TechxArtisan/Openterface_KeyMod_Hardware/hardware/v1_29(keymode plus)/BOM_29keymod plus_PCB24_30_2026-08-19.xlsx

No. | Quantity | Comment | Designator | Footprint | Value | Manufacturer Part | Manufacturer | Supplier Part | Supplier
1 | 2 | 12pF | C1,C2 | C0402 | 12pF
2 | 1 | 10uF | C11 | C0402 | 10uF | HGC0402R5106M100NTEJ | Chinocera(华瓷) | C7472949 | LCSC
3 | 1 | 100nF | C12 | C0402 | 100nF | CL05B104KO5NNNC | SAMSUNG(三星) | C1525 | LCSC
4 | 3 | 1uF | C13,C26,C27 | C0402 | 1uF
5 | 3 | 100nF | C15,C17,C20 | C0402 | 100nF
6 | 1 | 22nF | C25 | C0402 | 22nF
7 | 2 | B5819WS | D1,D3 | SOD-323_L1.8-W1.3-LS2.5-RD |  | B5819WS |  | C499641 | LCSC
8 | 1 | ANT-F-2-2.4G-0.8mmFR4_1 | E2 | ANT-F-2-2.4G-0.8mmFR4_1
9 | 1 | LED_0402-G | LED1 | LED_0402
10 | 2 | 10kΩ | R3,R4 | R0402 | 10kΩ | 0402WGF1002TCE | UNI-ROYAL(厚声) | C25744 | LCSC
11 | 2 | 5.1K | R9,R22 | R0402 | 5.1K
12 | 1 | 10K | R20 | R0402 | 10K
13 | 1 | 10k | R21 | R0402 | 10k
14 | 1 | B3U-1000P | SW1 | KEY-SMD_B3U-1000PM |  | B3U-1000P | OMRON(欧姆龙) | C231329 | LCSC
15 | 1 | CH32V208GBU6 | U2 | QFN-28_L4.0-W4.0-P0.40-BL-EP2.8 |  | CH32V208GBU6 | WCH(南京沁恒) | C7434833 | LCSC
16 | 1 | SY6280AAC | U6 | SOT-23-5_L3.0-W1.7-P0.95-LS2.8-BL |  | SY6280AAC | silergy(矽力杰) | C55136 | LCSC
17 | 1 | RT9193-33GB | U25 | SOT-23-5_L3.0-W1.7-P0.95-LS2.8-BL |  | RT9193-33GB | RICHTEK(立锜) | C15651 | LCSC
18 | 1 | USB-212-BCW | USB1 | USB-A-SMD_USB-212-BCW |  | USB-212-BCW | XUNPU(讯普) | C720521 | LCSC
19 | 1 | TYPE-C 16PIN 2MD(073) | USB2 | USB-C-SMD_TYPE-C-16PIN-2MD-073 |  | TYPE-C 16PIN 2MD(073) | SHOU HAN(首韩) | C2765186 | LCSC
20 | 1 | 32.768kHz | X1 | CRYSTAL-SMD_2P-L2.0-W1.2 | 32.768kHz | XKHEL89CGI-112YLC-32.768K | YXC(扬兴晶振) | C7500573 | LCSC
21 | 1 | 32MHz | X3 | CRYSTAL-SMD_4P-L3.2-W2.5-BL | 32MHz | X322532MOB4SI | YXC(扬兴晶振) | C9009 | LCSC
