TechxArtisan/Openterface_KeyMod_Hardware/hardware/v1_29(keymode plus)/3D_PCB24_30_2026-08-19.step

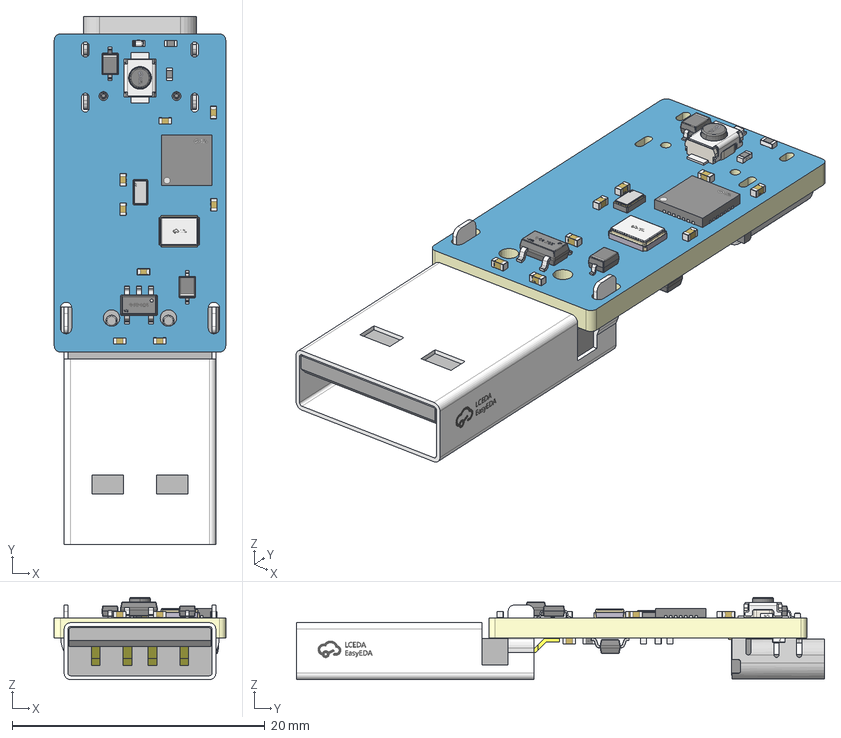
[picture p1: CAD file, 2026-08-19]
hardware/v1_29(keymode plus)/3D_PCB24_30_2026-08-19.step
13.6 x 41.8 x 6.50 mm
Board~2uqJ
TopCopper~2uqJ
BottomCopper~2uqJ
TopSilkscreen~2uqJ
BottomSilkscreen~2uqJ
TopFpcStiffener~2uqJ
BottomFpcStiffener~2uqJ
LED_0402~LED0402-RD_ORANGE~plJm
ANT-F-2-2.4G-0.8mmFR4_1~RES-SMD_L2.0-W1.2-R1-10K-R2-20K~k0gQ
R0402~R0402_L1.0-W0.5-H0.5~JtEf x 2
CRYSTAL-SMD_2P-L2.0-W1.2~CRYSTAL-SMD_2P-L2.0-W1.2~otiJ
R0402~R0402_L1.0-W0.5-H0.4~VwKX x 4
KEY-SMD_B3U-1000PM~KEY-SMD_2P-L3.0-W2.5-H1.6-LS4.0~yrwB
C0402~C0402_L1.0-W0.5-H0.5~60uz x 11
SOD-323_L1.8-W1.3-LS2.5-RD~SOD-323_L1.8-W1.3-LS2.5-RD~587r x 2
CRYSTAL-SMD_4P-L3.2-W2.5-BL~CRYSTAL-SMD_4P-L3.2-W2.5-BL~9JKJ
SOT-23-5_L3.0-W1.7-P0.95-LS2.8-BL~SOT-23-5_L2.9-W1.6-H1.1-LS2.8-P0.95~0K0i x 2
USB-C-SMD_TYPE-C-16PIN-2MD-073~USB-C-SMD_TYPE-C-6PIN-2MD-073~PgNu
USB-A-SMD_USB-212-BCW~USB-A-SMD_USB-212-BCW~Nbmz
QFN-28_L4.0-W4.0-P0.40-BL-EP2.8~QFN-28_L4.0-W4.0-P0.40-BL-EP2.8~fo4n
