TechxArtisan/Openterface_KeyMod_Hardware/hardware/v1_30(keymode)/3D_PCB24_23_2026-08-19.step

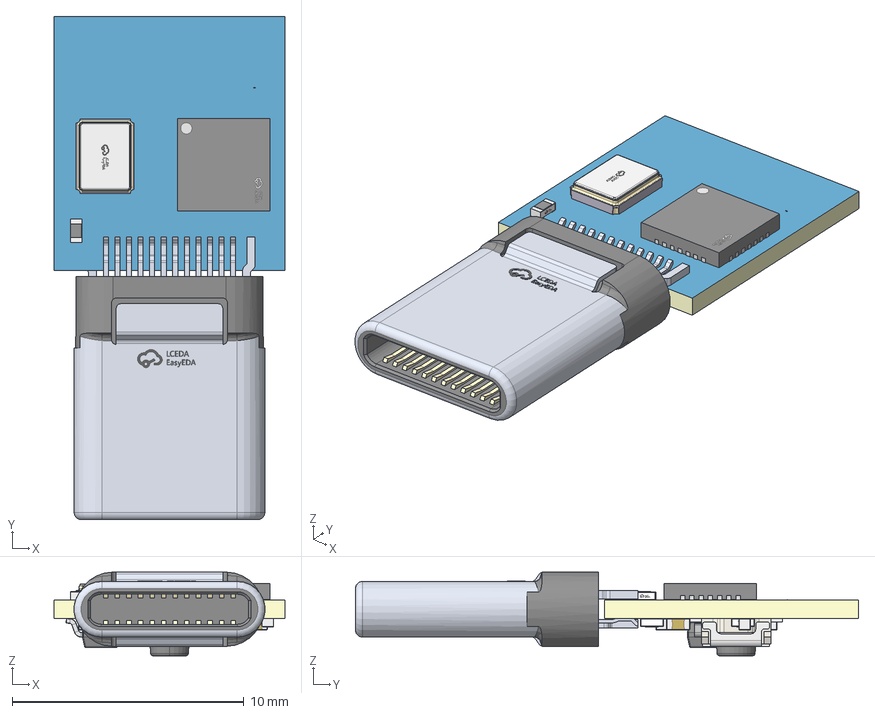
[picture p2: CAD file, 2026-08-19]
hardware/v1_30(keymode)/3D_PCB24_23_2026-08-19.step
9.97 x 21.7 x 3.61 mm
Board~ZbYg
TopCopper~ZbYg
BottomCopper~ZbYg
TopSilkscreen~ZbYg
BottomSilkscreen~ZbYg
TopFpcStiffener~ZbYg
BottomFpcStiffener~ZbYg
CRYSTAL-SMD_4P-L3.2-W2.5-BL~CRYSTAL-SMD_4P-L3.2-W2.5-BL~TsUA
C0402~C0402_L1.0-W0.5-H0.5~thjE x 4
R0402~R0402_L1.0-W0.5-H0.4~OVhD x 3
SOT-23-5_L3.0-W1.7-P0.95-LS2.8-BL~SOT-23-5_L2.9-W1.6-H1.1-LS2.8-P0.95~euPC
QFN-28_L4.0-W4.0-P0.40-BL-EP2.8~QFN-28_L4.0-W4.0-P0.40-BL-EP2.8~Exyz
LED_0402~LED0402-RD_ORANGE~qI0n
KEY-SMD_B3U-1000PM~KEY-SMD_2P-L3.0-W2.5-H1.6-LS4.0~fbtZ
USB-C-SMD_TYPE-C-24P-GTJB-040~USB-C-SMD_TYPE-C-24P-GTJB-040~geYN
ANT-F-2-2.4G-0.8mmFR4_1~CONN-TH_A254F2L1-2W14P11~fUU2
