TechxArtisan/Openterface_KeyMod_Hardware/models/KeyMod Mini/KeyModMini.stl

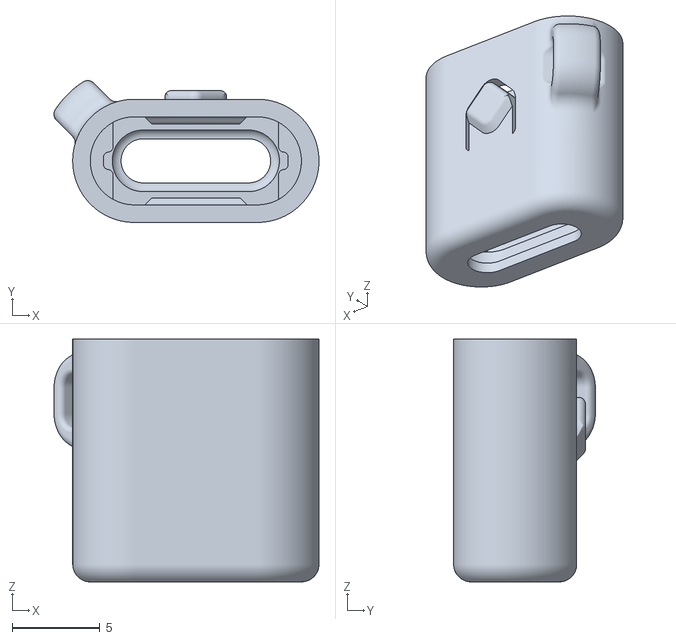
[picture p3: CAD file, 2026-09-04]
models/KeyMod Mini/KeyModMini.stl
15.1 x 8.06 x 13.8
