TechxArtisan/Openterface_KeyMod_Hardware/models/KeyMod Plus/KeyModPlus_Back_cover.stl

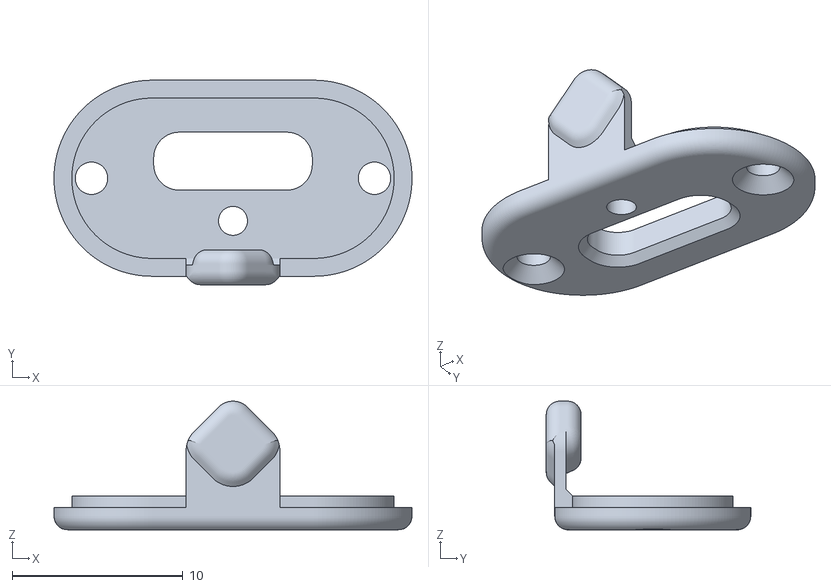
[picture p4: CAD file, 2026-09-04]
models/KeyMod Plus/KeyModPlus_Back_cover.stl
21.0 x 12.0 x 7.55
