TechxArtisan/Openterface_KeyMod_Hardware/models/KeyMod Mini/KeyModMini_Cover.stl

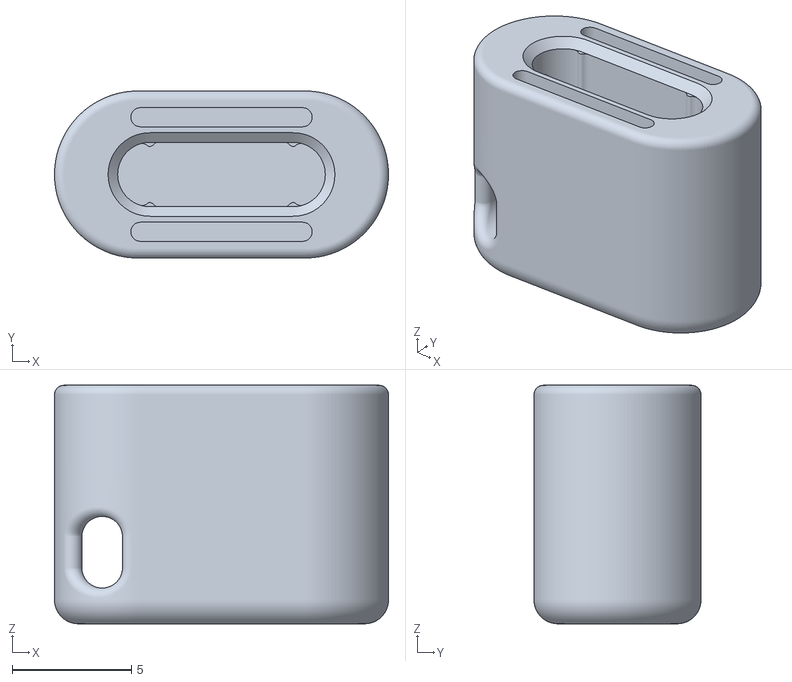
[picture p5: CAD file, 2026-09-04]
models/KeyMod Mini/KeyModMini_Cover.stl
14.0 x 7.00 x 10.0
