TechxArtisan/Openterface_KeyMod_Hardware/models/KeyMod Plus/KeyModPlus.stl

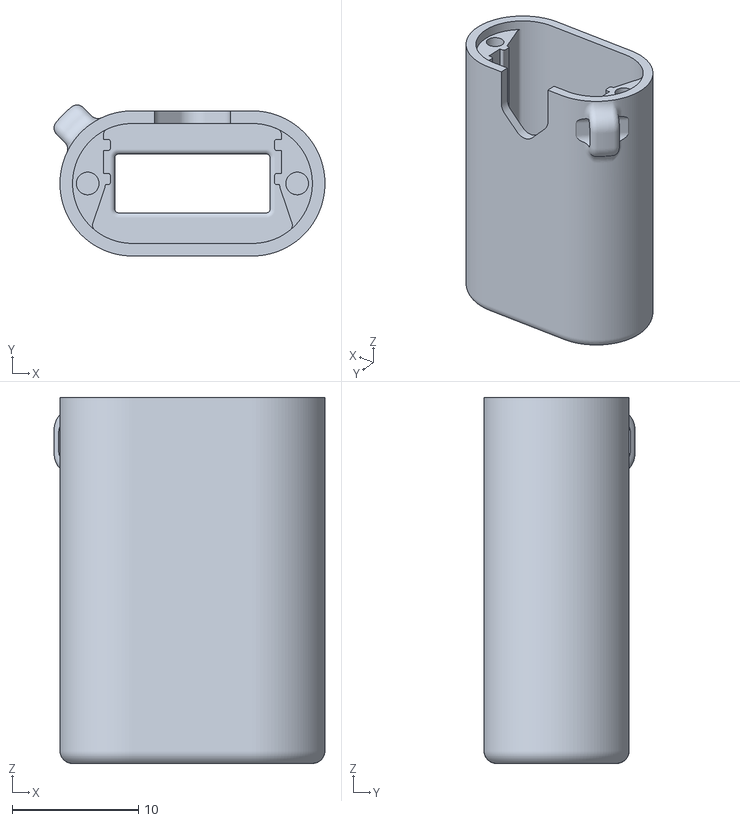
[picture p6: CAD file, 2026-09-04]
models/KeyMod Plus/KeyModPlus.stl
21.5 x 12.0 x 29.0
