TechxArtisan/Openterface_KeyMod_Hardware/models/KeyMod Mini/KeyModMini_Back_cover.stl

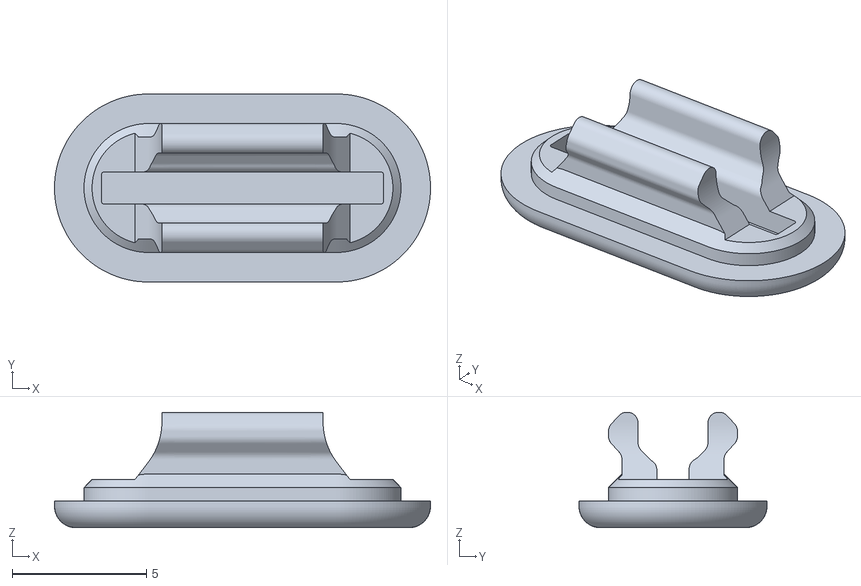
[picture p7: CAD file, 2026-09-04]
models/KeyMod Mini/KeyModMini_Back_cover.stl
14.0 x 7.00 x 4.30
