TechxArtisan/Openterface_KeyMod_Hardware/models/KeyMod Plus/KeyModPlus-Cover.stl

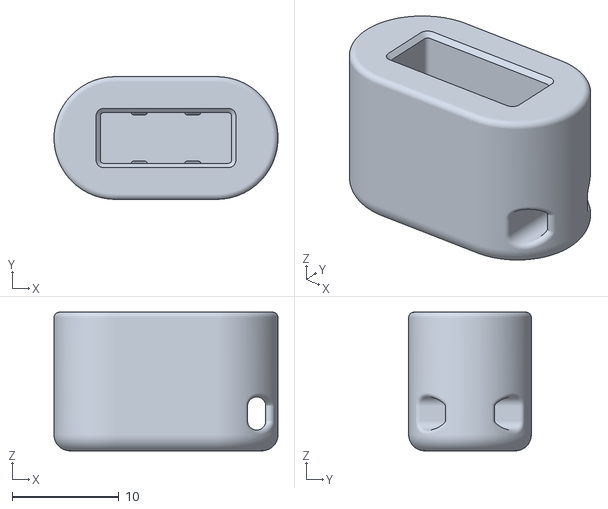
[picture p8: CAD file, 2026-09-04]
models/KeyMod Plus/KeyModPlus-Cover.stl
21.0 x 11.5 x 13.0
