TechxArtisan/Openterface_KeyMod_Hardware/(list of files, cad)

Other CAD files:
models/KeyMod Mini/KeyModMini.f3d
models/KeyMod Mini/KeyModMini_Back_cover.f3d
models/KeyMod Mini/KeyModMini_Cover.f3d
models/KeyMod Plus/KeyModPlus.f3d
models/KeyMod Plus/KeyModPlus_Back_cover.f3d
models/KeyMod Plus/KeyModPlus_Cover.f3d
