TechxArtisan/Openterface_KeyMod_Hardware/hardware/v1_29(keymode plus)/SCH_Schematic7_31_2026-08-19.pdf

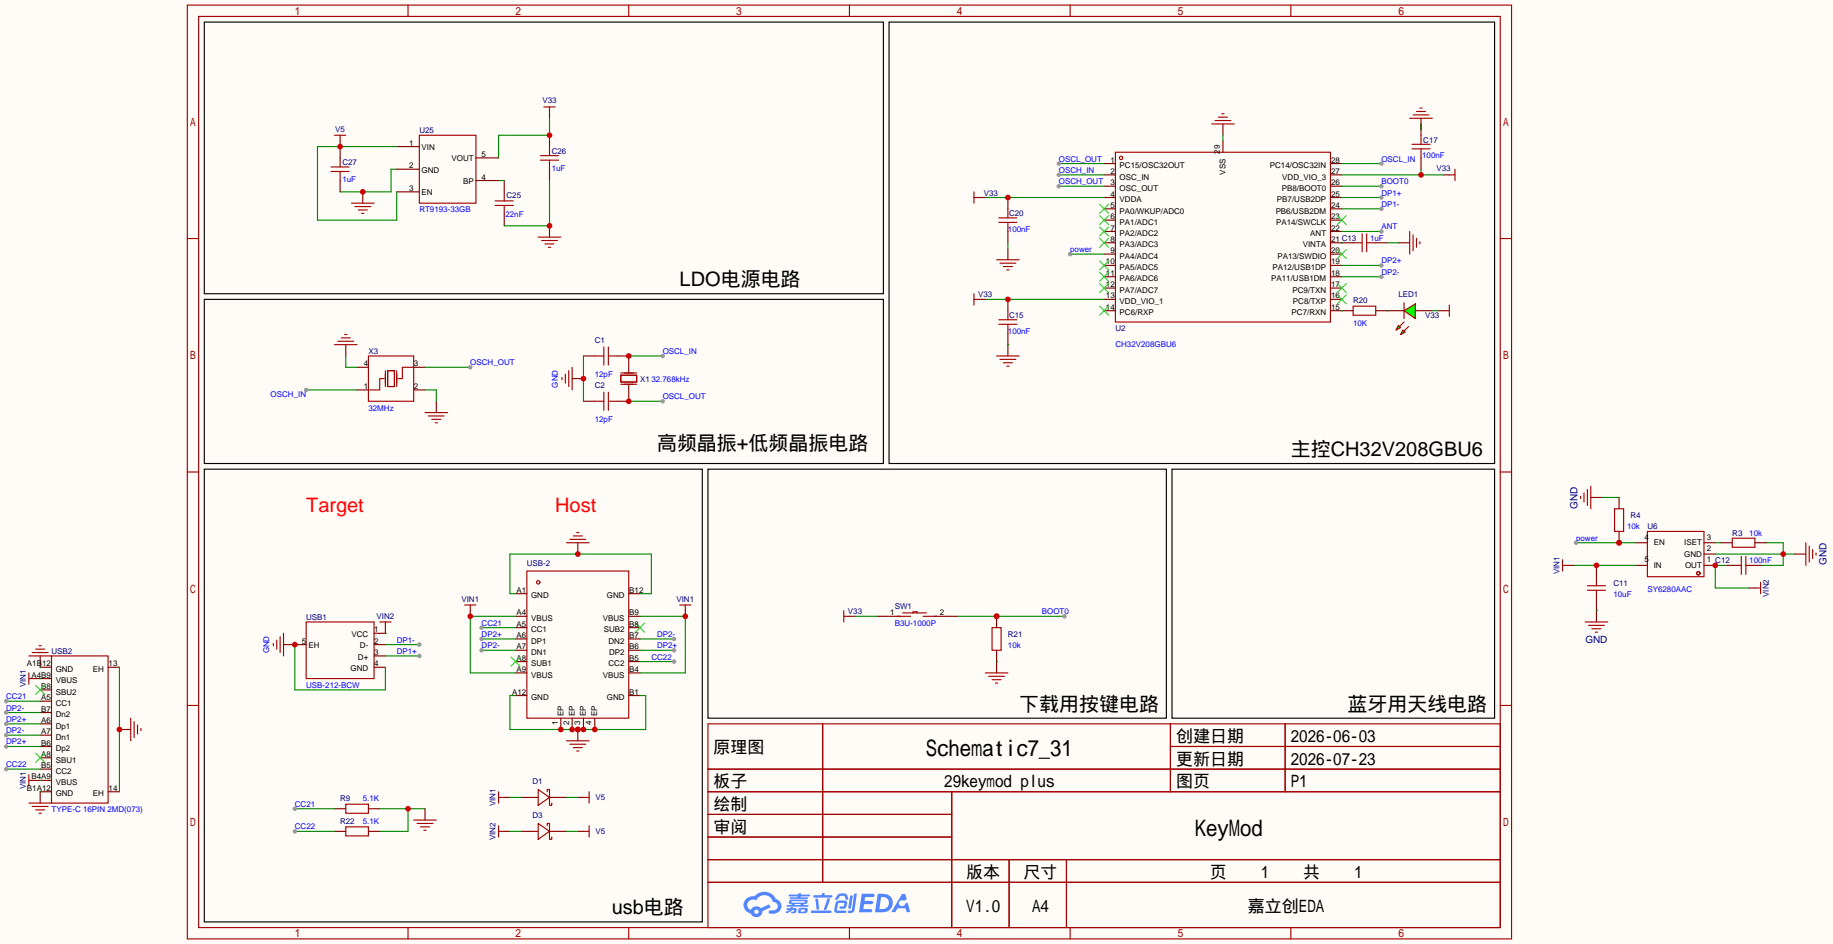
[picture p13: page 1]

原理图 | Schematic7_31 | 创建日期 | 2026-06-03

更新日期 | 2026-07-23

板子 | 29keymod plus | 图页 | P1
绘制 | | KeyMod
审阅

V1.0 | A4 | 嘉立创EDA
