TechxArtisan/Openterface_KeyMod_Hardware/hardware/v1_30(keymode)/PCB_PCB24_23_2026-08-19.pdf

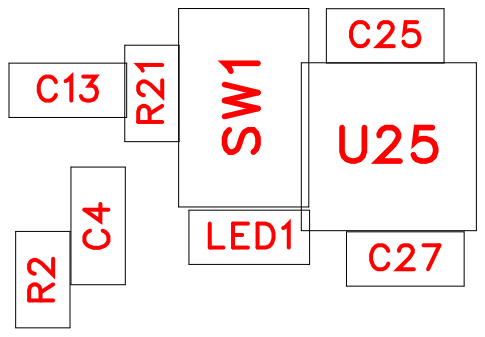
[picture p14: page 2]

No. | Quantity | Comment | Designator | Footprint | Value | Manufacturer Part | Manufacturer | Supplier Part | Supplier
1 | 1 | 1uF | C4 | C0402 | 1uF | CL05A105KA 5NQNC | SAMSUNG( ) 三星 | C52923 | LCSC
2 | 2 | 1uF | C13,C27 | C0402 | 1uF
3 | 1 | 22nF | C25 | C0402 | 22nF
4 | 1 | ANT-F-2-2.4 G-0.8mmFR4 _1 | E1 | ANT-F-2-2.4 G-0.8mmFR4 _1
5 | 1 | LED_0402-G | LED1 | LED_0402
6 | 1 | 5.1K | R1 | R0402 | 5.1K
7 | 1 | 10k | R2 | R0402 | 10k | RT0402BRD 0710KL | YAGEO(国巨 ) | C190095 | LCSC
8 | 1 | 10k | R21 | R0402 | 10k
9 | 1 | B3U-1000P | SW1 | KEY-SMD_B 3U-1000PM | | B3U-1000P | OMRON( 欧 ) 姆龙 | C231329 | LCSC
10 | 1 | TYPE-C 24P-GTJB 040 | U1 | USB-C-SMD _TYPE-C-24 P-GTJB-040 | | TYPE-C 24P-GTJB 040 | SHOU HAN(首韩 ) | C3151751 | LCSC
11 | 1 | CH32V208G BU6 | U2 | QFN-28_L4.0 -W4.0-P0.40-BL-EP2.8 | | CH32V208G BU6 | WCH(南京沁 恒) | C7434833 | LCSC
12 | 1 | RT9193-33G B | U25 | SOT-23-5_L3 .0-W1.7-P0.9 5-LS2.8-BL | | RT9193-33G B | RICHTEK( 立 锜 ) | C15651 | LCSC
13 | 1 | 32MHz | X3 | CRYSTAL-S MD_4P-L3.2-W2.5-BL | 32MHz | X322532MO B4SI | YXC(扬兴晶 振) | C9009 | LCSC

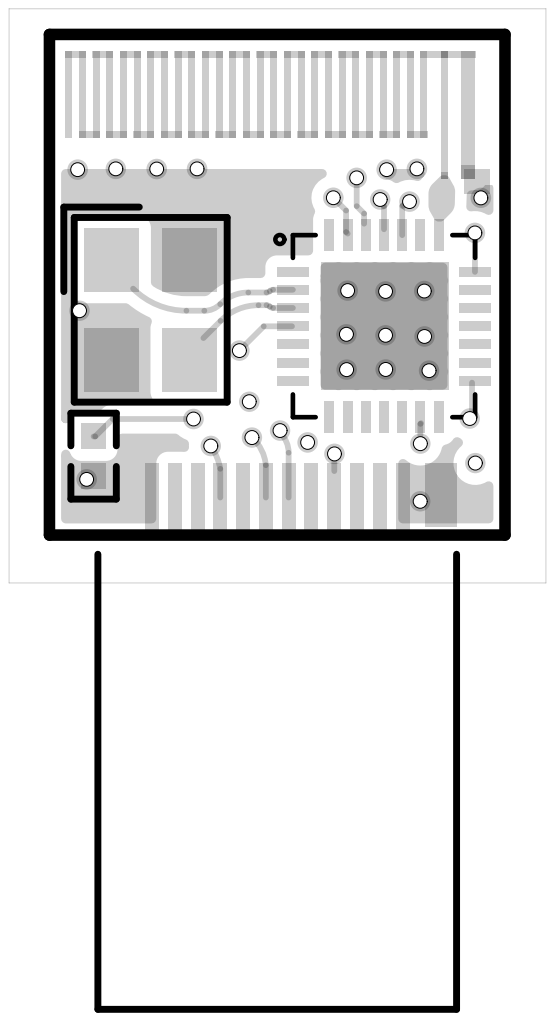
[picture p15: page 4]

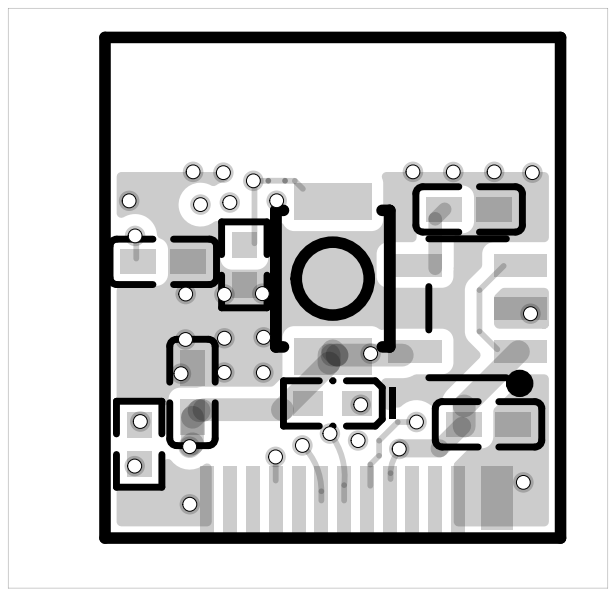
[picture p16: page 5]
