TechxArtisan/Openterface_KeyMod_Hardware/hardware/v1_30(keymode)/SCH_Schematic7_24_2026-08-19.pdf

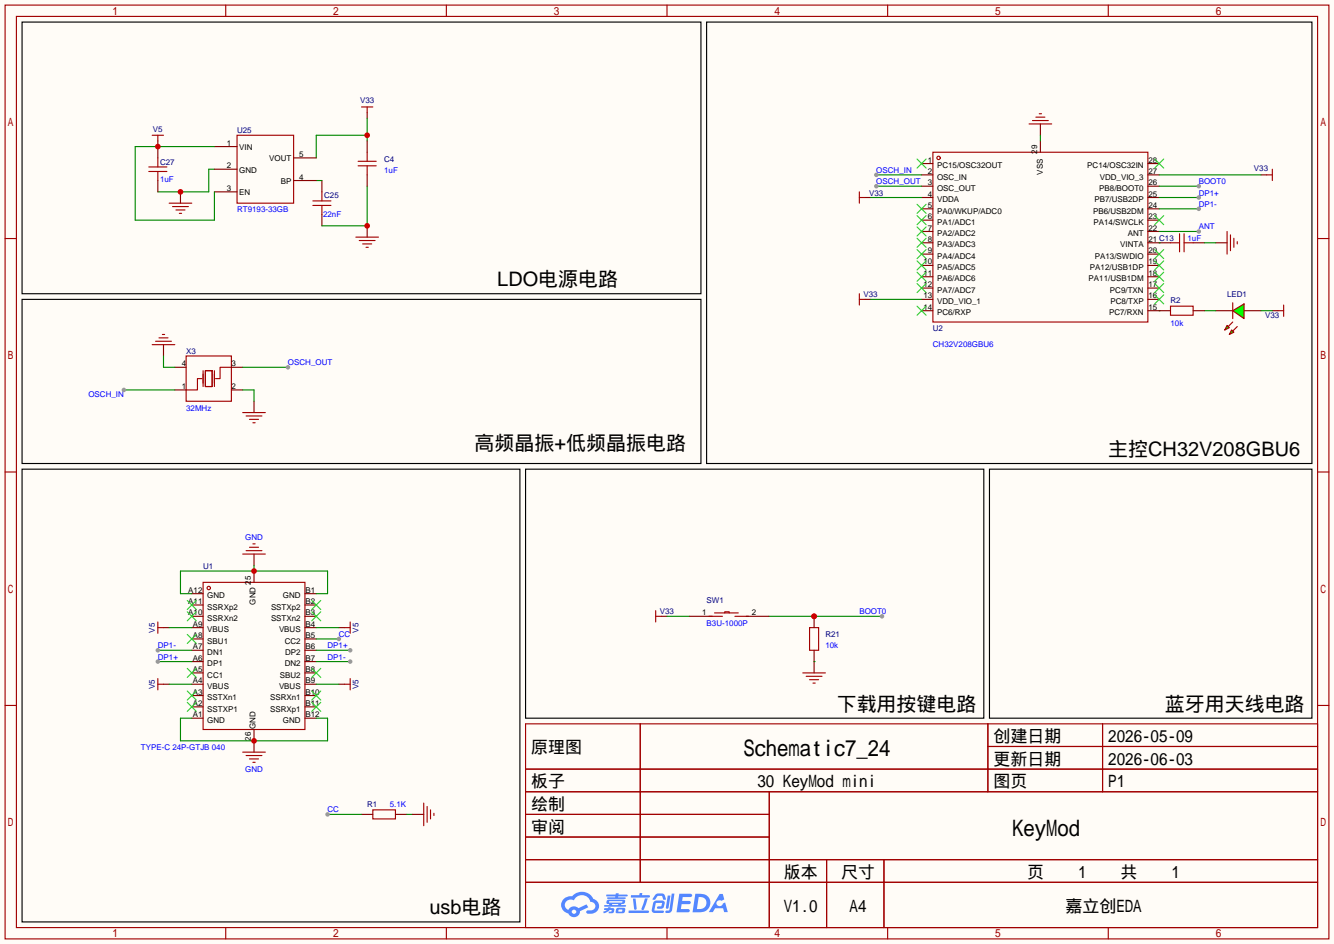
[picture p17: page 1]

原理图 | Schematic7_24 | 创建日期 | 2026-05-09

更新日期 | 2026-06-03

板子 | 30 KeyMod mini | 图页 | P1
绘制 | | KeyMod
审阅

V1.0 | A4 | 嘉立创EDA
