TechxArtisan/Openterface_KeyMod_Hardware/hardware/v1_30(keymode)/KiCad_file/ProDoc_30 KeyMod mini_2026-08-18/ProDoc_30 KeyMod mini_2026-08-18.kicad_pcb

## KiCad design hardware/v1_30(keymode)/KiCad_file/ProDoc_30 KeyMod mini_2026-08-18/ProDoc_30 KeyMod mini_2026-08-18.kicad_pcb (2026-08-19)

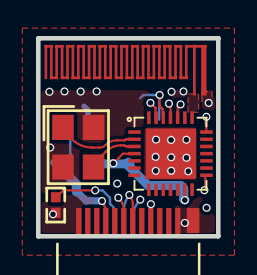
[picture p18: board ProDoc_30 KeyMod mini_2026-08-18.kicad_pcb from above]

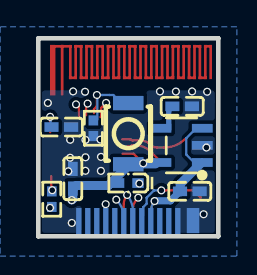
[picture p19: board ProDoc_30 KeyMod mini_2026-08-18.kicad_pcb from below]

Board: 4 copper layers, 10.0 x 11.0 mm, 14 parts (9 on the bottom side), 14 nets.

Parts:
C4, C13, C25, C27: C0402
E1: ANT-F-2-2.4G-0.8mmFR4_1
LED1: LED_0402
R1, R2, R21: R0402
SW1: KEY-SMD_B3U-1000PM
U1: USB-C-SMD_TYPE-C-24P-GTJB-040
U2: QFN-28_L4.0-W4.0-P0.40-BL-EP2.8
U25: SOT-23-5_L3.0-W1.7-P0.95-LS2.8-BL
X3: CRYSTAL-SMD_4P-L3.2-W2.5-BL

Connections:
$1N1726: C13.1, U2.21
$1N1787: C25.2, U25.4
$1N12770: LED1.1, R2.2
$1N12771: R2.1, U2.15
ANT: E1.1, U2.22
BOOT0: R21.2, SW1.2, U2.26
CC: R1.1, U1.B5
DP1+: U1.A6, U1.B6, U2.25
DP1-: U1.A7, U1.B7, U2.24
GND: C4.1, C13.2, C25.1, C27.1, E1.0, R1.2, R21.1, U1.25, U1.26, U1.A1, U1.A12, U1.B1, U1.B12, U2.29, U25.2, X3.2, X3.4
OSCH_IN: U2.2, X3.1
OSCH_OUT: U2.3, X3.3
V5: C27.2, U1.A4, U1.A9, U1.B4, U1.B9, U25.1, U25.3
V33: C4.2, LED1.2, SW1.1, U2.4, U2.13, U2.27, U25.5
