TechxArtisan/Openterface_KeyMod_Hardware/hardware/v1_29(keymode plus)/KiCad_file/ProDoc_29keymod plus_2026-08-19/ProDoc_29keymod plus_2026-08-19.kicad_pcb

## KiCad design hardware/v1_29(keymode plus)/KiCad_file/ProDoc_29keymod plus_2026-08-19/ProDoc_29keymod plus_2026-08-19.kicad_pcb (2026-08-19)

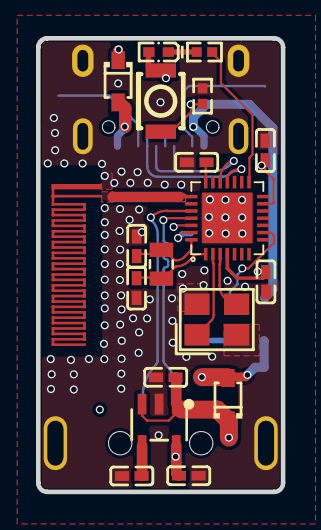
[picture p20: board ProDoc_29keymod plus_2026-08-19.kicad_pcb from above]

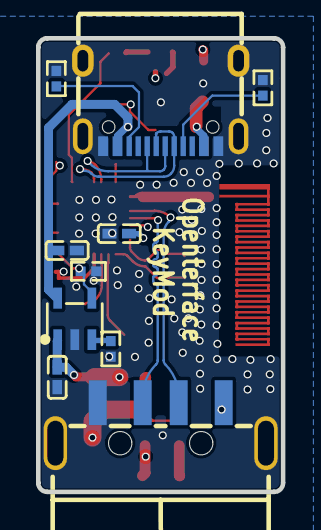
[picture p21: board ProDoc_29keymod plus_2026-08-19.kicad_pcb from below]

Board: 4 copper layers, 13.6 x 25.2 mm, 29 parts (10 on the bottom side), 22 nets.

Parts:
C1, C2, C11, C12, C13, C15, C17, C20, C25, C26, C27: C0402
D1, D3: SOD-323_L1.8-W1.3-LS2.5-RD
E2: ANT-F-2-2.4G-0.8mmFR4_1
LED1: LED_0402
R3, R4, R9, R20, R21, R22: R0402
SW1: KEY-SMD_B3U-1000PM
U2: QFN-28_L4.0-W4.0-P0.40-BL-EP2.8
U6, U25: SOT-23-5_L3.0-W1.7-P0.95-LS2.8-BL
USB1: USB-A-SMD_USB-212-BCW
USB2: USB-C-SMD_TYPE-C-16PIN-2MD-073
X1: CRYSTAL-SMD_2P-L2.0-W1.2
X3: CRYSTAL-SMD_4P-L3.2-W2.5-BL

Connections:
$1N1726: C13.1, U2.21
$1N1787: C25.2, U25.4
$1N12722: R20.2, U2.15
$1N14813: LED1.1, R20.1
$1N14821: R3.2, U6.3
BOOT0: R21.2, SW1.2, U2.26
CC21: R9.1, USB2.A5
CC22: R22.1, USB2.B5
DP1+: U2.25, USB1.3
DP1-: U2.24, USB1.2
DP2+: U2.19, USB2.A6, USB2.B6
DP2-: U2.18, USB2.A7, USB2.B7
GND: C1.1, C2.1, C11.1, C12.2, C13.2, C15.1, C17.1, C20.1, C25.1, C26.1, C27.1, R3.1, R4.2, R9.2, R21.1, R22.2, U2.29, U6.2, U25.2, USB1.4, USB1.5, USB2.13, USB2.14, USB2.A1B12, USB2.B1A12, X3.2, X3.4
OSCH_IN: U2.2, X3.1
OSCH_OUT: U2.3, X3.3
OSCL_IN: C1.2, U2.28, X1.2
OSCL_OUT: C2.2, U2.1, X1.1
V5: C27.2, D1.1, D3.1, U25.1, U25.3
V33: C15.2, C17.2, C20.2, C26.2, LED1.2, SW1.1, U2.4, U2.13, U2.27, U25.5
VIN1: C11.2, D1.2, U6.5, USB2.A4B9, USB2.B4A9
VIN2: C12.1, D3.2, U6.1, USB1.1
power: R4.1, U2.9, U6.4
