TechxArtisan/Openterface_KeyMod_Hardware/(commit log)

2026-08-19 Add hardware v1.30
    [3D_PCB24_23_2026-08-19.step, BOM_30 KeyMod mini_PCB24_23_2026-08-19.xlsx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]
2026-08-19 Add hardware v1.29
    [3D_PCB24_30_2026-08-19.step, BOM_29keymod plus_PCB24_30_2026-08-19.xlsx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]
2026-08-19 Add hardware rename
    [3D_PCB24_23_2026-08-19.step, 3D_PCB24_30_2026-08-19.step, BOM_29keymod plus_PCB24_30_2026-08-19.xlsx, BOM_30 KeyMod mini_PCB24_23_2026-08-19.xlsx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]
2026-09-04 KeyModMini and KeyModPlus 3D models
    [KeyModMini.stl, KeyModMini_Back_cover.stl, KeyModMini_Cover.stl, KeyModPlus-Cover.stl, KeyModPlus.stl, KeyModPlus_Back_cover.stl]
2026-09-04 KeyMod Mini and KeyMod Plus 3D Models
    [KeyModMini.f3d, KeyModMini.stl, KeyModMini_Back_cover.f3d, KeyModMini_Back_cover.stl, KeyModMini_Cover.f3d, KeyModMini_Cover.stl, KeyModPlus-Cover.stl, KeyModPlus.f3d]
2026-10-12 Initialize README.md with project details
    Added detailed overview, features, firmware, software, PCB design, licensing, and contribution information for the Openterface KeyMod hardware.
